cyberimmunity-edu/cyberimmune-systems-autonomous-delivery-drone-with-kos-hardware/README.md

# Киберимунный автономный квадрокоптер

## Подборка материалов для сборки киберимунного квадрокоптера

* [Детали](PARTS_LIST.md)
* [Чертежи и модели](./parts/SCHEMATICS.md)
* [Схемы плат и подключений](./schematics/)
