cyberimmunity-edu/cyberimmune-systems-autonomous-delivery-drone-with-kos-hardware/parts/SCHEMATICS.md

# Чертежи деталей и модели

## Содержание

* [Коптер сборка](#коптер-сборка)
* [Верхняя дека](#верхняя-дека)
* [Комплект стенок](#комплект-стенок)
* [Корпус для 2х компасов V3](#корпус-для-2х-компасов_v3)
* [Корпус под шарик 20мм](#корпус-под-шарик-20мм-v12-2)
* [Крест](#крест)
* [Крышка для 2х компасов V3](#крышка-для-2х-компасов-v3)
* [Нижняя дека](#нижняя-дека)
* [Планшайба килсвитч](#планшайба-килсвитч)
* [Скоба крепления к раме](#скоба-крепления-к-раме)
* [Спуск2](#спуск2)
* [Стойка](#стойка)
* [Фланец Стойки](#фланец-стойки-22)

## Коптер сборка

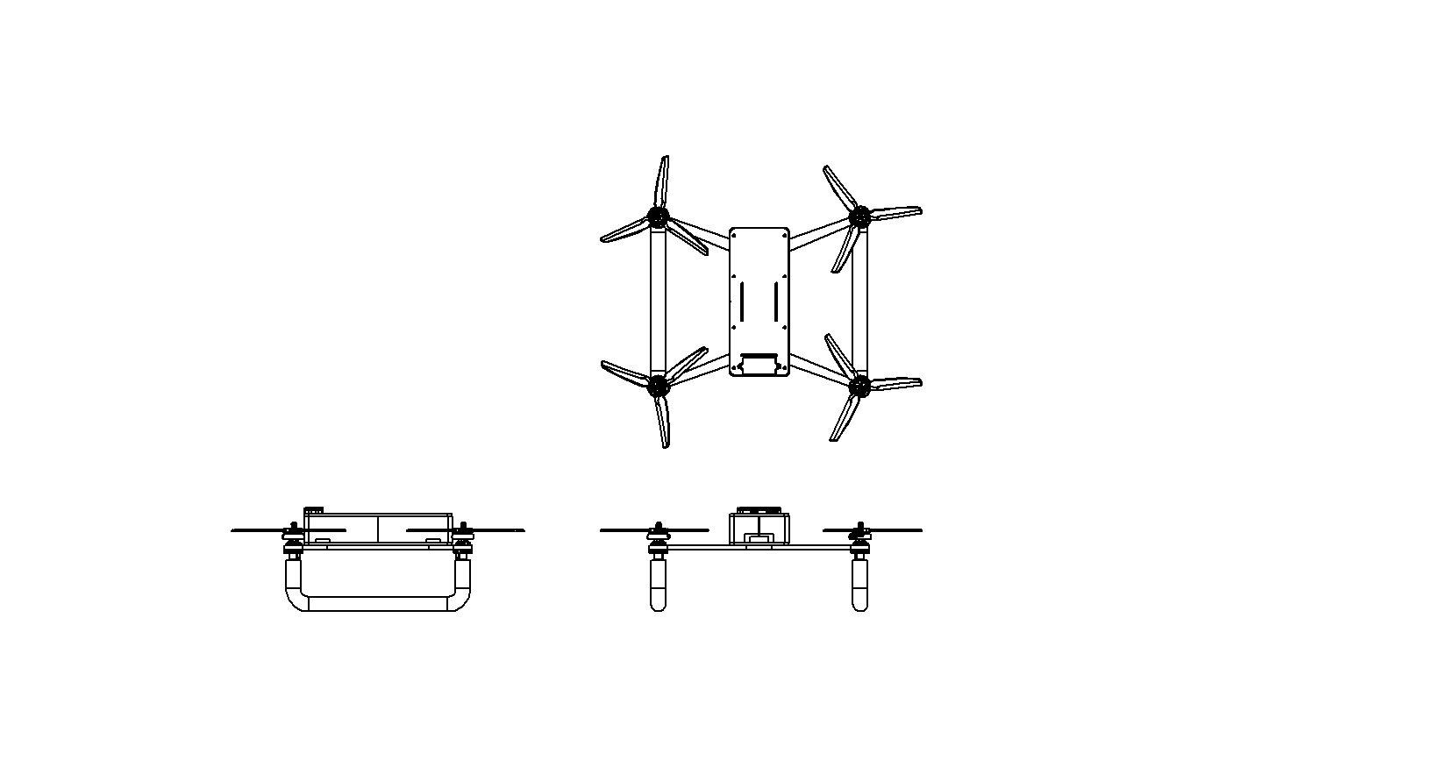
[picture p1: parts/Коптер_сборка.png]

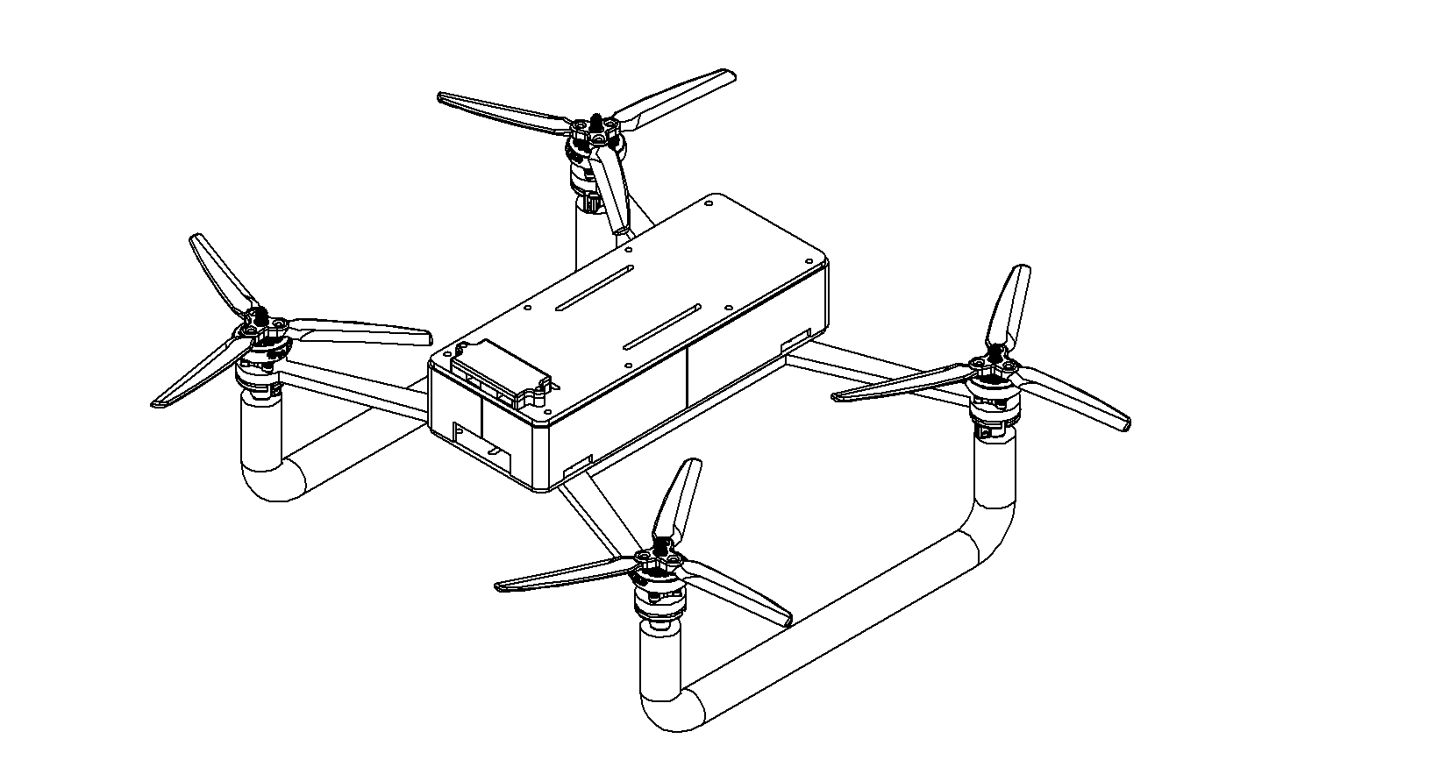
[picture p2: parts/Коптер_сборка_дим.png]


## Верхняя дека

* [Верхняя_дека.DWG](./Верхняя_дека.DWG)
* [Верхняя_дека.SLDPRT](./Верхняя_дека.SLDPRT)

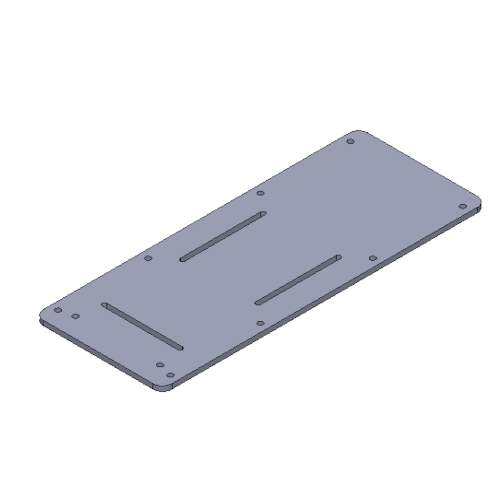
[picture p3: parts/Верхняя_дека.png]

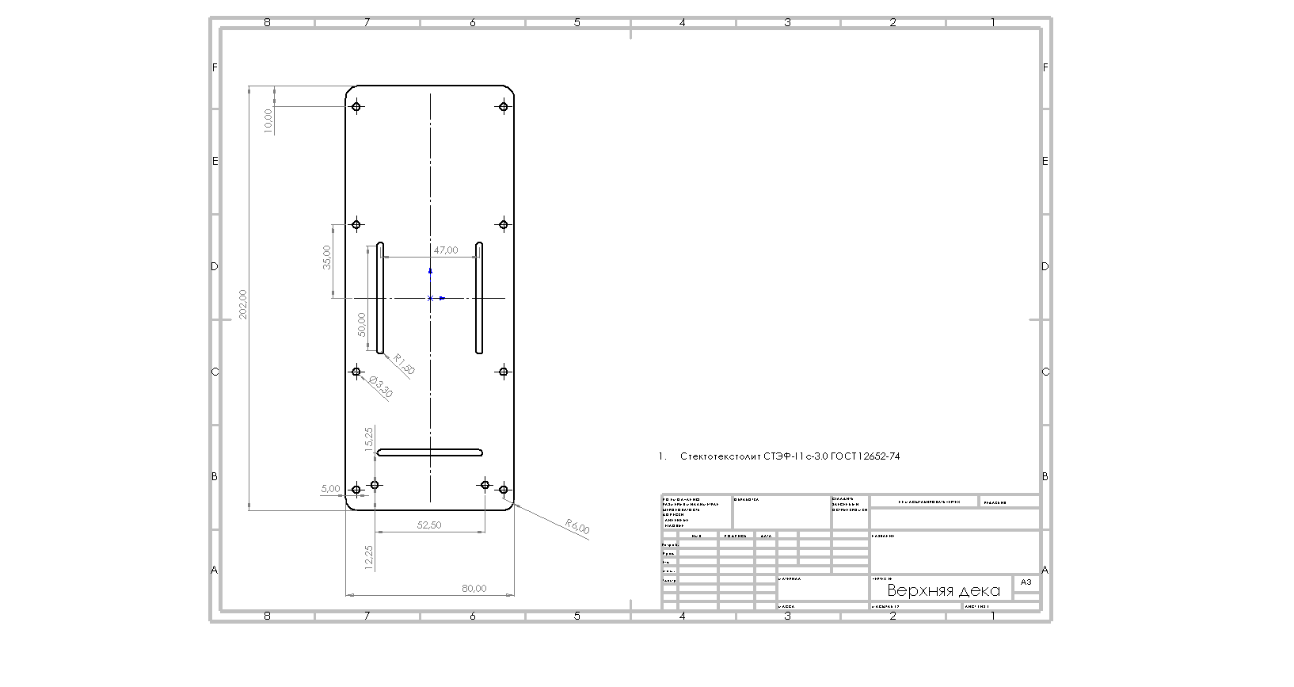
[picture p4: parts/Верхняя_дека_чертёж.png]


## Комплект стенок

* [Комплект_стенок.SLDPRT](./Комплект_стенок.SLDPRT)

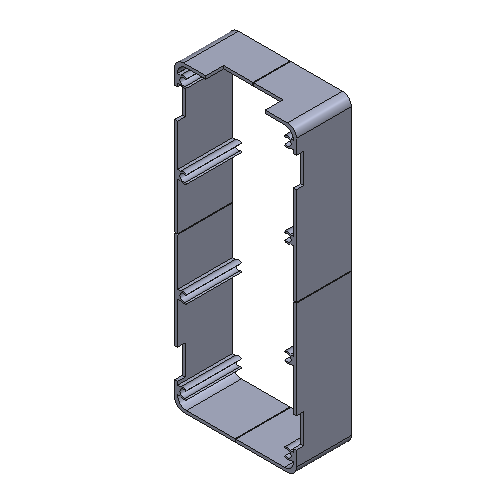
[picture p5: parts/Комплект_стенок.png]

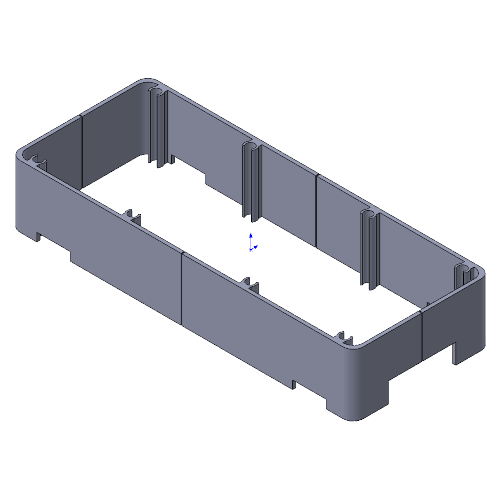
[picture p6: parts/Комплект_стенок2.png]


## Корпус для 2х компасов_V3

* [Корпус_для_2х_компасов_V3.SLDPRT](./Корпус_для_2х_компасов_V3.SLDPRT)

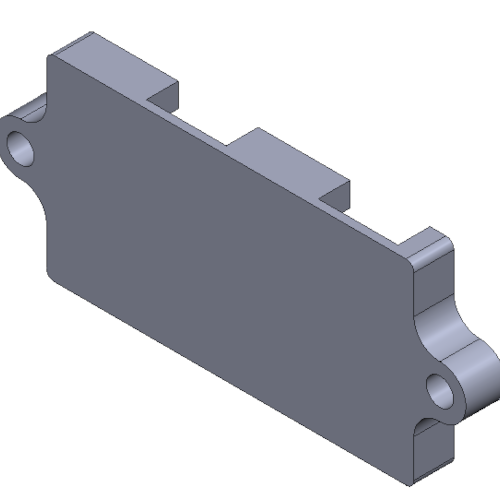
[picture p7: parts/Корпус_для_2х_компасов_V3.png]


## Корпус под шарик 20мм v1.2-2

* [Корпус_под_шарик_20мм_v1.2.SLDPRT](./Корпус_под_шарик_20мм_v1.2.SLDPRT)
* [Корпус_под_шарик_20мм_v1.2.STL](./Корпус_под_шарик_20мм_v1.2.STL)

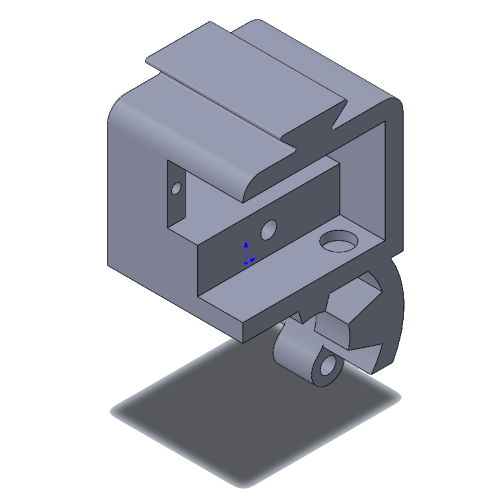
[picture p8: parts/Корпус_под_шарик_20мм_v1.2-2.png]

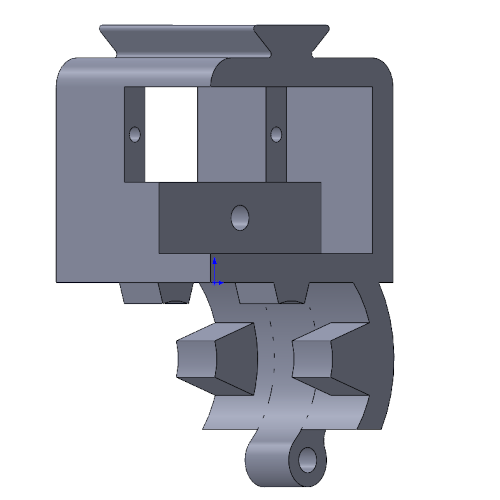
[picture p9: parts/Корпус_под_шарик_20мм_v1.2.png]


## Крест

* [Крест.DWG](./Крест.DWG)
* [Крест.SLDPRT](./Крест.SLDPRT)

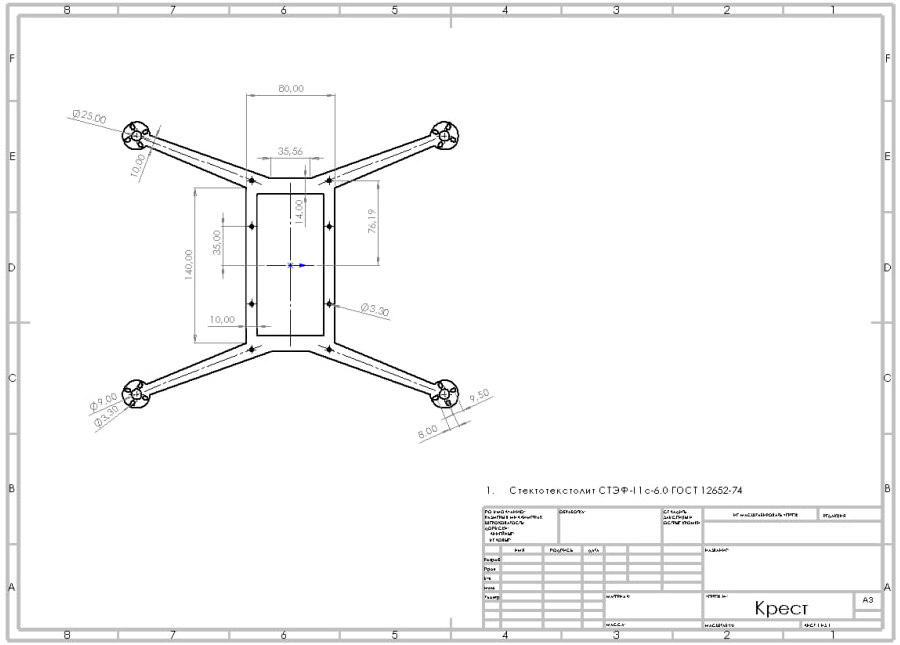
[picture p10: parts/Крест.png]

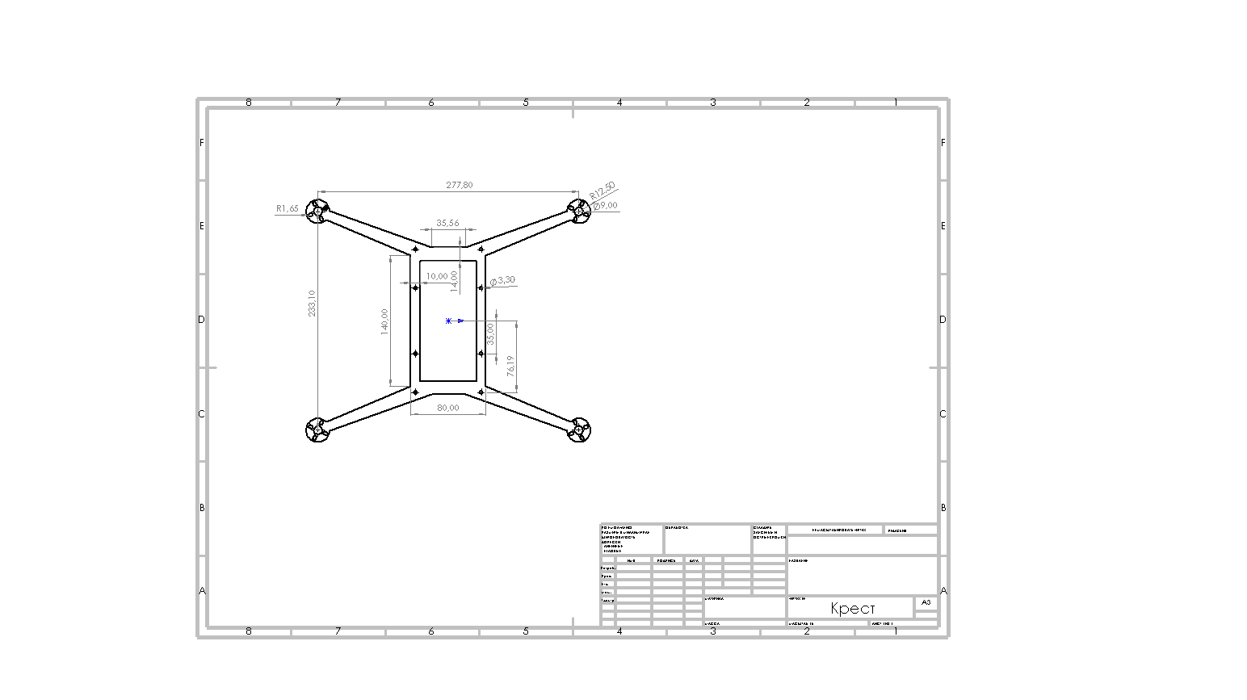
[picture p11: parts/Крест_чертёж.png]


## Крышка для 2х компасов V3

* [Крышка_для_2х_компасов_V3.SLDPRT](./Крышка_для_2х_компасов_V3.SLDPRT)
* [Крышка_под_шарик_20мм_v1.2.SLDPRT](./Крышка_под_шарик_20мм_v1.2.SLDPRT)
* [Крышка_под_шарик_20мм_v1.2.STL](./Крышка_под_шарик_20мм_v1.2.STL)

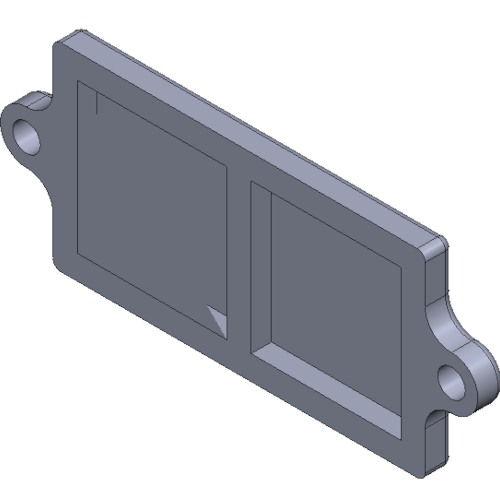
[picture p12: parts/Крышка_для_2х_компасов_V3.png]

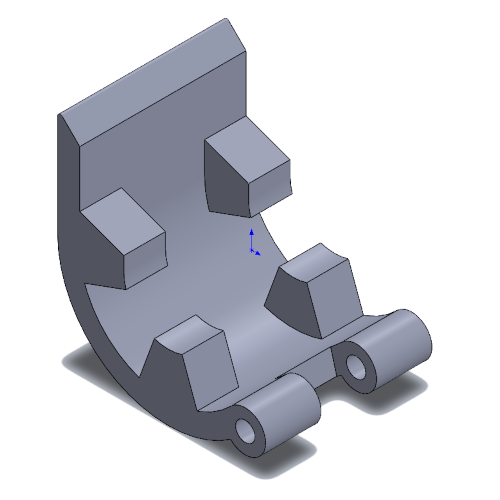
[picture p13: parts/Крышка_под_шарик_20мм_v1.2-2.png]

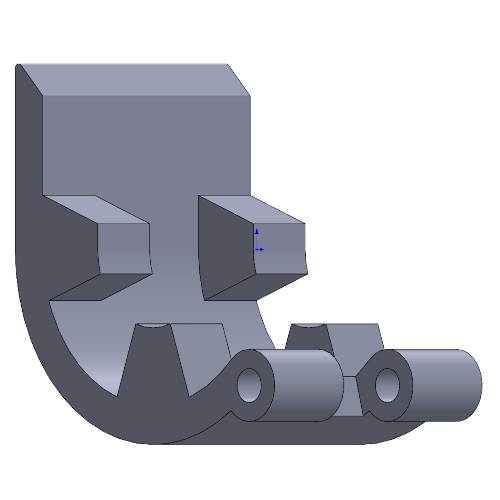
[picture p14: parts/Крышка_под_шарик_20мм_v1.2.png]


## Нижняя дека

* [Нижняя_дека.DWG](./Нижняя_дека.DWG)
* [Нижняя_дека.SLDPRT](./Нижняя_дека.SLDPRT)

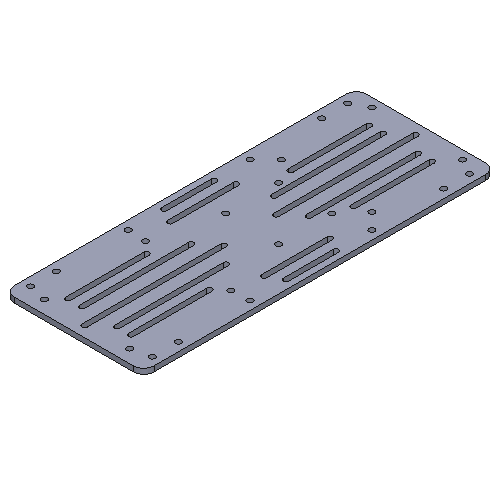
[picture p15: parts/Нижняя_дека.png]

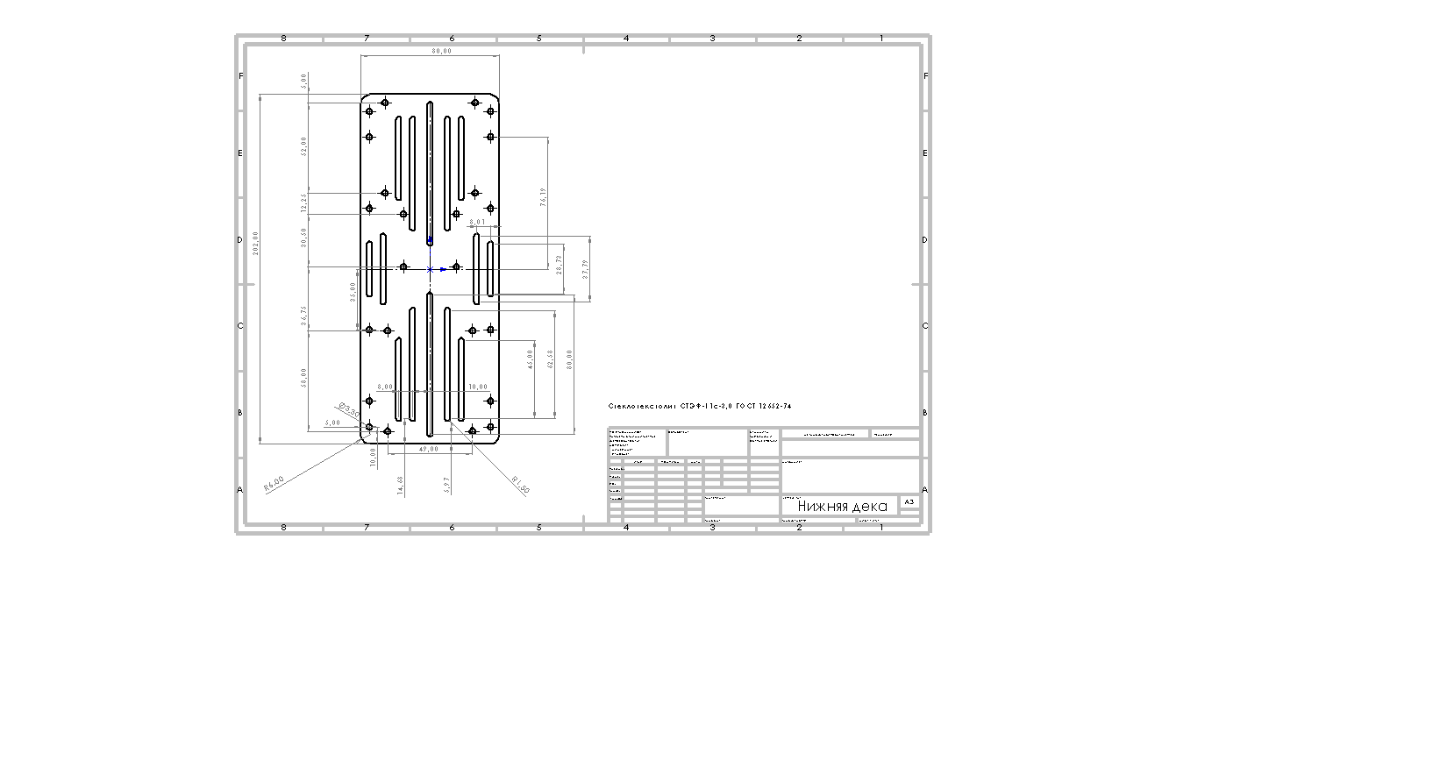
[picture p16: parts/Нижняя_дека_чертёж.png]


## Планшайба килсвитч

* [Планшайба_килсвитч.DWG](./Планшайба_килсвитч.DWG)
* [Планшайба_килсвитч.SLDPRT](./Планшайба_килсвитч.SLDPRT)

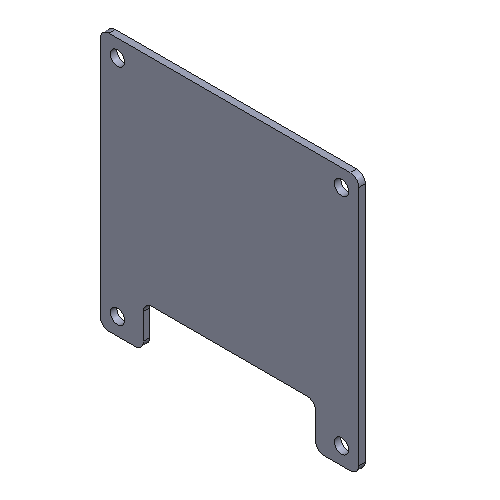
[picture p17: parts/Планшайба_килсвитч.png]

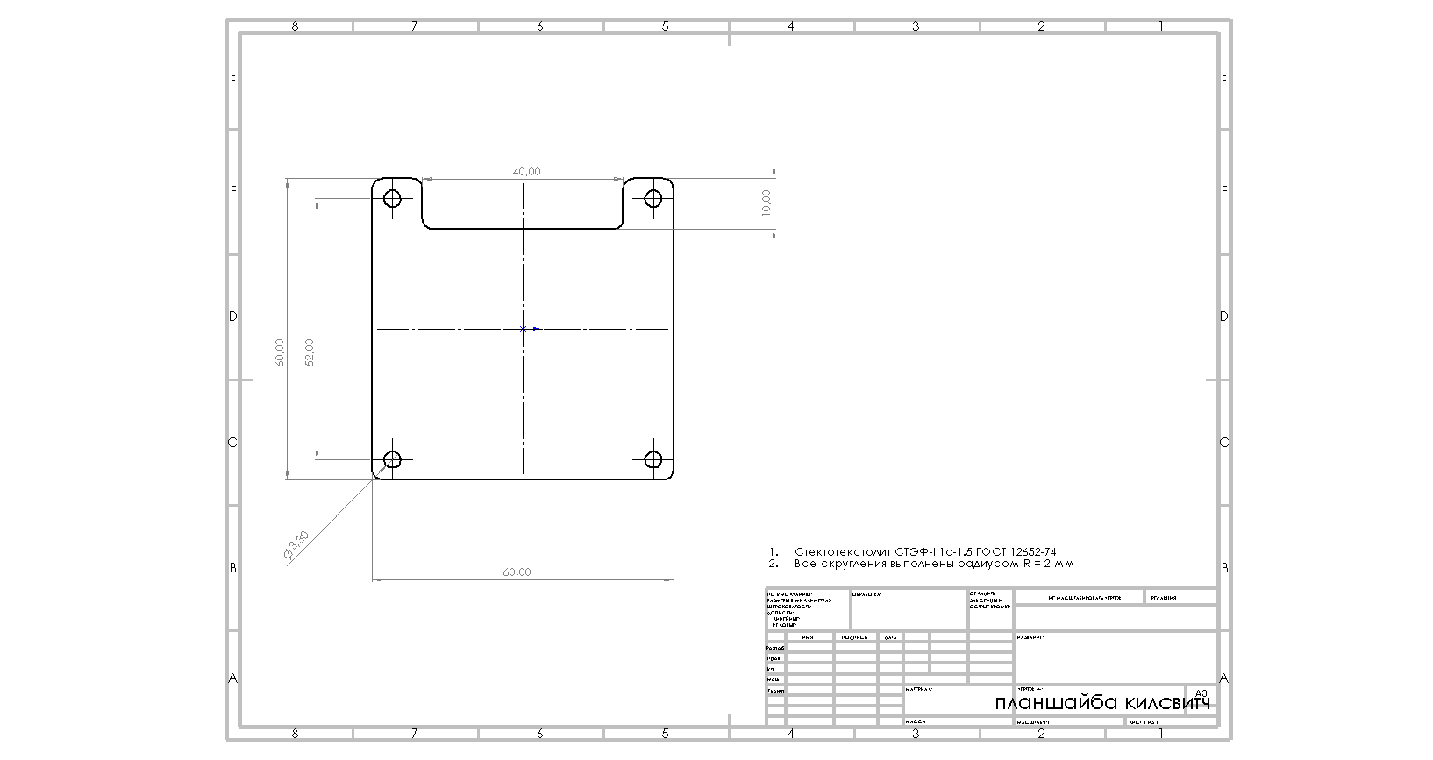
[picture p18: parts/Планшайба_килсвитч_чертёж.png]


## Подвес

* [Подвес_ИТОГ.SLDASM](./Подвес_ИТОГ.SLDASM)

## Рама Сборка

* [Рама_Сборка.SLDASM](./Рама_Сборка.SLDASM)

## Скоба крепления к раме

* [Скоба_крепления_к_раме.SLDPRT](./Скоба_крепления_к_раме.SLDPRT)
* [Скоба_крепления_к_раме.STL](./Скоба_крепления_к_раме.STL)

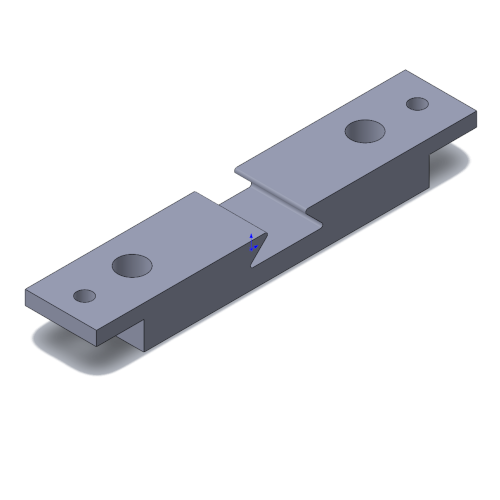
[picture p19: parts/Скоба_крепления_к_раме.png]


## Спуск2

* [Спуск2.SLDPRT](./Спуск2.SLDPRT)
* [Спуск2.STL](./Спуск2.STL)

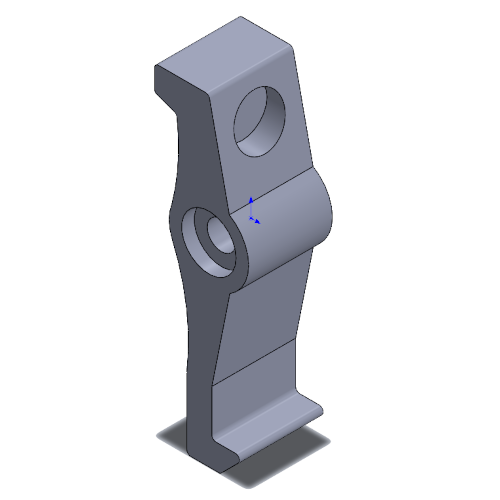
[picture p20: parts/Спуск2.png]


## Стойка

* [Стойка.SLDPRT](./Стойка.SLDPRT)

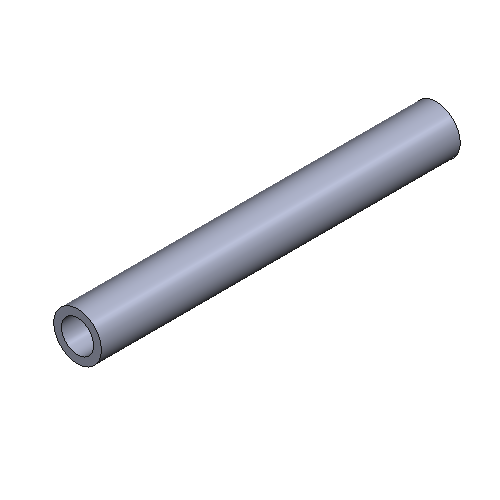
[picture p21: parts/Стойка.png]


## Фланец Стойки 2.2

* [Фланец_Стойки_2.2.SLDPRT](./Фланец_Стойки_2.2.SLDPRT)
* [Фланец_Стойки_2.2.STL](./Фланец_Стойки_2.2.STL)

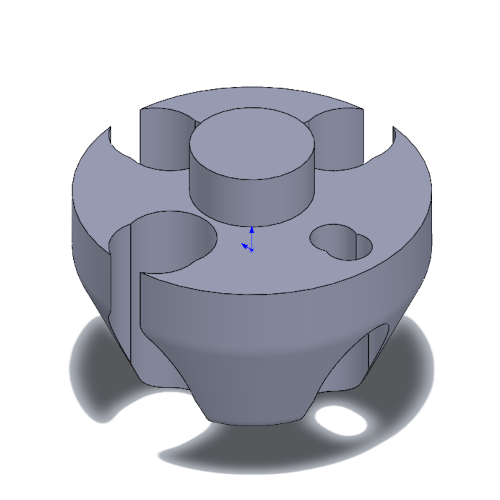
[picture p22: parts/Фланец_Стойки_2.2.png]
