cyberimmunity-edu/cyberimmune-systems-autonomous-delivery-drone-with-kos-hardware/SPECS.md

# **Кибериммунный дрон доставщик**

## **Технические характеристики**

### **Дрон:**

| Взлетная масса | 913 грамм квадр \+ 201 грамм аккум = 1114 грамм общий вес |
| :---: | :---: |
| **Размеры в разложенном состоянии** | В разложенном состоянии (без пропеллеров) 308\*263\*143 (Д × Ш × В) |
| **Размер по диагонали**  | 362,6 мм |
| **Макс. скорость взлета** | в целях безопасности ограничена 3-5 м/с |
| **Макс. скорость снижения** | стандартно 2 м/с, на высоте ниже 1 м замедляется до 1 м/с |
| **Макс. полетная скорость (над уровнем моря, без ветра)** | 2-3 м/с ограничена 5 м/с |
| **Макс. потолок над уровнем моря** | 200 м |
| **Макс. полетное время (без ветра)** | 30 минут |
| **Макс. время зависания (с ветром)** | 23 минуты |
| **Макс. полетное расстояние** | 6 км |
| **Макс. допустимая скорость ветра** |  0-5 м/с комфортный <br /> 5-10 м/сек нагруженный <br /> 10-12 м/с экстремальный |
| **Макс. угол наклона** | 25° |
| **Диапазон рабочих температур** | ОТ \-10° до 40° C |
| **Глобальные системы позиционирования (GNSS)** | GPS \+ Galileo \+ BeiDou+Глонасс |

### **Аккумулятор:**

| Емкость | 4000 мА·ч |
| :---: | :---: |
| **Напряжение** | 14.8 В |
| **Предел напряжения зарядки** | 16.4 В |
| **Тип аккумулятора** | Литий-ионный 4S |
| **Энергетика** | 59.2 Вт·ч |
| **Масса** | 292 г |
| **Диапазон температур зарядки** | \+5°...+40° C |

## **Отличительные особенности:**

* **Автономность.**  
  Отсутствие пульта управления и полеты в режиме полной автономности согласно составленным полетным заданиям.

* **Производительность.**  
  Дрон оснащен высокопроизводительным одноплатным компьютером Raspberry Pi 4b для тестирования алгоритмов обеспечения безопасности полета и не только. Компьютер подключен к полетному контроллеру по интерфейсу UART и осуществляет взаимодействие с KasperskyOS по протоколу, поставляемому в SDK.

* **Безопасность.**  
  Для возможности экстренной остановки двигателей, дрон оборудован системой аварийного выключения используя команды модуля безопасности Raspberry Pi, путем разрыва цепи питания ESC.

* **Связь.**  
  Дрон способен осуществлять передачу телеметрии по протоколу MAVLINK используя сети Wi-Fi по средствам платы расширения ESP32

* **Аккумулятор.**  
  Поддержка любых Li-ion 4S и LiPo 4S аккумуляторов.

* **Полезная нагрузка.**  
  На нижней части квадрокоптера установлено крепление ласточкин хвост для установки и BLS разъем для подключения и подключения полезной нагрузки. Также предусмотрен модуль реле для принудительной деактивации полезной нагрузки.
