cyberimmunity-edu/cyberimmune-systems-autonomous-delivery-drone-with-kos-hardware/schematics/Gerber_PCB_Buzzer_2024-06-27.png

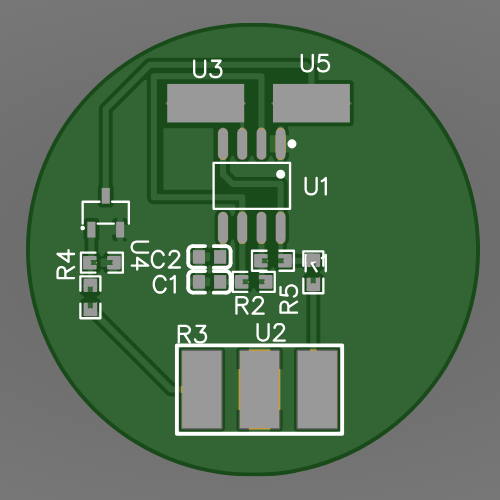
schematics/Gerber_PCB_Buzzer_2024-06-27.png
