cyberimmunity-edu/cyberimmune-systems-autonomous-delivery-drone-with-kos-hardware/schematics/scheme.jpg

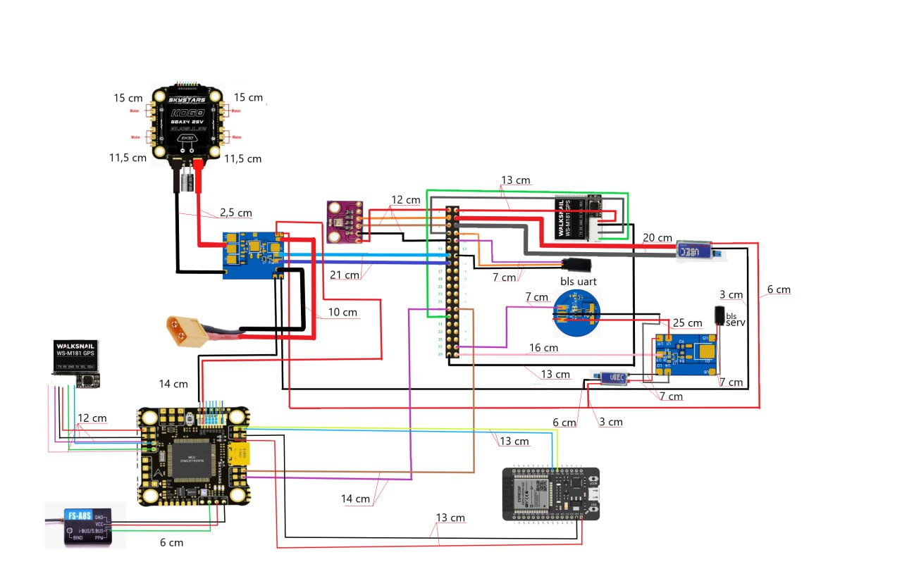
schematics/scheme.jpg
