cyberimmunity-edu/cyberimmune-systems-autonomous-delivery-drone-with-kos-hardware/schematics/scheme.png

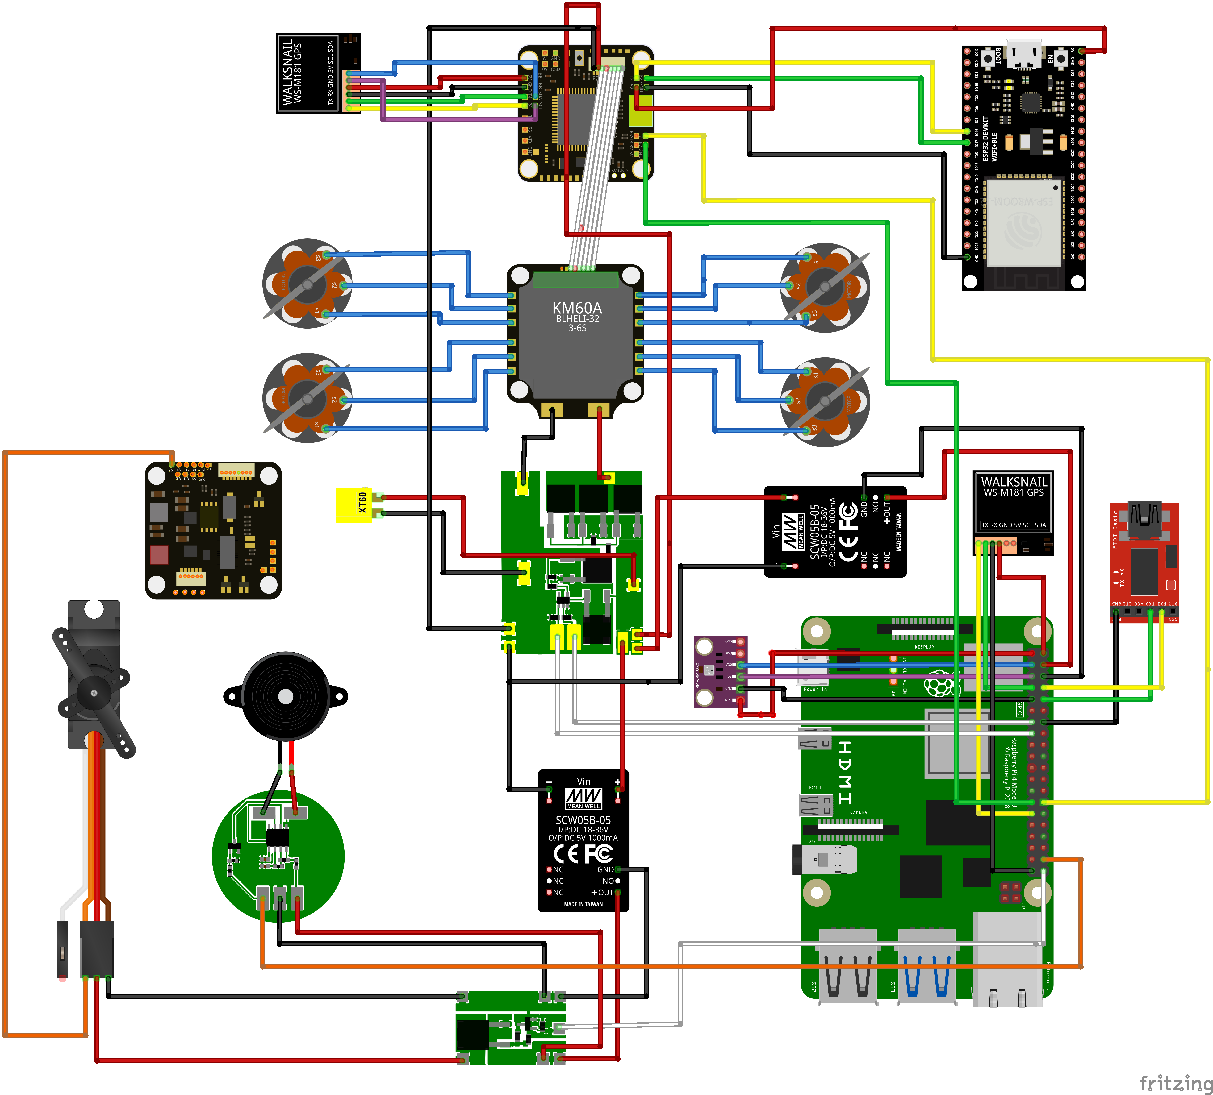
schematics/scheme.png
