cyberimmunity-edu/cyberimmune-systems-autonomous-delivery-drone-with-kos-hardware/PARTS_LIST.md

# Список запчастей

| Наименование | Количество | Примечание  |
| --- | --- | --- |
| 2N7002MTF исполнение SOT-23-3 | 1 | шт buzzer |
| 2N7002MTF исполнение SOT-23-3 | 1 | шт - реле |
| Аккумулятор 14.8В 3000мАч 4S LiIon XT60 GEPRC VTC6 18650 | 1 |  |
| Алюминевый скотч | 405 | В мм, на один коптер Экранирование gps на верхней деке,  возможно будем убирать. |
| антенна rasberry 2.4 | 1 шт или 2 | |
| Барометр BMP280 | 1 | Барометр |
| Болт М2.5 полиамид | 4 | Крепление raspberry |
| Болт М3 полиамид | 4 | Крепление планшайбы, предложение заменить на 2,5 с целью унификации |
| Зарядное устройство | 1 | Для зарядки аккумуляторов. |
| Изолента черная | 2 рулона | Крепление проводов к лучам |
| Кабель канал спиральный 8 мм | 1 рулон | Кабель менеджмент |
| карты памяти 8GB 10класс  | 1 | Запись системы KOS |
| Ключ для BLS разъема | 1 | Пластмаска со штырьком что бы не перепутать подключение |
| Ключ М8 | 1 | Для моторов |
| Колодка 40 Pin | 1 | Подключение на гребенку RPi |
| Комплект стенок | 1 | ABS пластик (18891мм), на 1 комплект в комплекте (4 детали) |
| кондер  10 nF исполнение С0603 | 1 | шт buzzer |
| кондер 33 nF исполнение С0603 | 1 | шт buzzer |
| Коробка 335*290*175мм | 1 |  |
| Корпус | 1 | ABS пластик (8624мм),  на 1шт. |
| Корпус для 2-х компасов | 1 | ABS пластик (1533мм) на 1шт. |
| Крышка | 1 | ABS пластик (4782мм), на 1шт. |
| Крышка для 2-х компасов | 1 | ABS пластик (1076мм) на 1 шт. |
| Маска  Dynamask 5030 | 1 рулон | Защита и изоляция самодельных плат |
| Модуль реле | 1 | Собственное производство  |
| Пластина крепления | 1 | ABS пластик (3095мм),  на 1шт. |
| Припой | 1 катушка | Пайка |
| Пропеллеры HQProp J75 CCW | 2 |  |
| Пропеллеры HQProp J75 CW | 2 |  |
| Пружина 0,5*4,3*12 n=6 | 1 | Подходит от авторучки |
| резистор 10 кОМ исполнение R0603 | 2 | шт buzzer |
| резистор 10 кОМ исполнение R0603 | 3 | шт - killswitch |
| резистор 10 кОМ исполнение R0603 | 1 | шт - реле |
| резистор 100 кОм исполнение R0603 | 1 | шт - killswitch |
| резистор 100 кОм исполнение R0603 | 1 | шт - реле |
| резистор 100 Ом исполнение R0603 | 2 | шт buzzer |
| резистор 100 Ом исполнение R0603 | 2 | шт - killswitch |
| резистор 100 Ом исполнение R0603 | 2 | шт - реле |
| резистор 11 кОм исполнение R0603 | 1 | шт buzzer |
| Сервопривод MG-90 | 1 | Комплект с винтами и качалками |
| Силиконовый провод 14awg красный | 50 | мм, +, KS -> ESC |
| Силиконовый провод 14awg чёрный  | 50 | мм, gnd, KS -> ESC |
| Силиконовый провод awg28 белый | 100 | мм, control, RPi => Buzzer |
| Силиконовый провод awg28 белый | 210 | мм, control, KS=>RPi |
| Силиконовый провод awg28 белый | 210 | мм, control, KS=>RPi |
| Силиконовый провод awg28 желтый | 120 | мм, Tx, Bar -> RPi |
| Силиконовый провод awg28 желтый | 130 | мм, Tx, ESP32 => RPi |
| Силиконовый провод awg28 желтый | 140 | мм, Tx, ПК => RPi |
| Силиконовый провод awg28 желтый | 70 | мм, Tx, RPi => UART |
| Силиконовый провод awg28 желтый | 300 | мм, Tx, TTL => UART |
| Силиконовый провод awg28 зелёный | 120 | мм,  Rx, Bar -> RPi |
| Силиконовый провод awg28 зелёный | 130 | мм, Rx, ESP32 => RPi |
| Силиконовый провод awg28 зелёный | 140 | мм, Rx, ПК => RPi |
| Силиконовый провод awg28 зелёный | 70 | мм, Rx, RPi => UART |
| Силиконовый провод awg28 зелёный | 300 | мм, Rx, TTL => UART |
| Силиконовый провод awg28 красный | 120 | мм, VCC, Bar -> RPi |
| Силиконовый провод awg28 красный | 130 | мм, gnd, ESP32 => RPi |
| Силиконовый провод awg28 красный | 180 | мм, +,  МР => Buzzer |
| Силиконовый провод awg28 красный | 70 | мм, наращивание питания на ПК |
| Силиконовый провод awg28 чёрный | 120 | мм, gnd |  Bar -> RPi |
| Силиконовый провод awg28 чёрный | 130 | мм, + |  ESP32 => RPi |
| Силиконовый провод awg28 чёрный | 70 | мм, gnd |  RPi => UART |
| Силиконовый провод awg28 чёрный | 180 | мм, gnd |  МР => Buzzer |
| Силиконовый провод awg28 чёрный | 70 | мм, наращивание питания на ПК |
| Силиконовый провод awg28 чёрный | 300 | мм, gnd |  TTL => UART |
| Скотч двухсторонний | 1 рулон | Креплние UART, бары KillSwitch, esp32, модуль реле, пропеллеры для транспортировки |
| Сода кальцинированная | 1 упаковка | Чистка самодельных плат от маски |
| Спуск | 1 | ABS пластик(851мм), на 1шт. |
| Стеклотекстолит типа FR4 | 1 | 30x30mm buzzer |
| Стеклотекстолит типа FR4 | 1 | 42х32mm - killswitch |
| Стеклотекстолит типа FR4 | 1 | 25х18мм- реле |
| Стойка алюминиевая М3*37мм | 8 | Использованы стойки геоскана, есть предложение замены на 35мм(место позволяет, плюс экономия веса) или на 40мм (Есть в магазинах), либо заказ из Китая 37мм |
| Стойка нейлоновая для печатных плат HTS M2,5*6 | 4 | Крепление raspberry |
| Стойка нейлоновая для печатных плат HTS M3*20 | 4 | Крепление планшайбы, предложение заменить на 2,5 с целью унификации |
| Столбики из ППЭ 50*20*175 | 4 |  |
| Стэк Skystars H7HD + KM60 | 1 | ПК + ESC |
| Текстолит СТЭФ-I, 1.5 мм | 1 | полка заготовка (60*60*1,5), возможно количество будет изменено на 2шт. |
| Текстолит СТЭФ-I, 3 мм | 2 | верхняя дека и нижняя дека (202*80*3)*2, возможно замена материала на 1,5мм на верхней деке, а возможно и на обоих |
| Текстолит СТЭФ-I, 6 мм | 1 | крест рамы, (258,1*302,8*6) |
| Теплоизоляция для труб 22*6 мм | 343 | Вспененный полиэтилен |
| Трубка алюминиевая 6*1 мм | 363мм | Нужен трубогиб |
| Трубка термоусадочная d1/0,5 белая | 1 рулон (5м) | Изоляция паяльных соединений |
| Фланец стойки шасси (3д печать) | 4 | ABS пластик (2119мм) на 1шт. |
| Флюс паяльный |  1 тюбик | Пайка |
| Шлейка для крепления Акб | 1 |  |
| BL-T, контакт для BLS и BLD | 22 | Колодка 40 Pin мамы |
| BL-TM, контакт для BLS и BLD | 3 | Вывод UART, BLS 3pin папы(штырьки) |
| BLS 3pin | 1 | Подключение Uart |
| BLS 3pin с ключом | 1 | Подключение Uart |
| Buzzer | 1 | Собственное производство  |
| Buzzer(ardupilot) | 1 | шт buzzer |
| DIN 555 / DIN 934 Гайка шестигранная с фаской M2.5 Полиамид | 4 | Крепление raspberry |
| DIN 555 / DIN 934 Гайка шестигранная с фаской M2.5 Полиамид | 4 | Крепление планшайбы, предложение заменить на 2,5 с целью унификации |
| DIN 912 / ISO 4762 Винт с цилиндрической головкой и внутренним шестигранником M3*12 | 2 | Крепление креста с нижней декой к стойкам |
| DIN 912 / ISO 4762 Винт с цилиндрической головкой и внутренним шестигранником M3*16 | 4 | Крепление нижней деки к кресту |
| DIN 912 / ISO 4762 Винт с цилиндрической головкой и внутренним шестигранником M3*6 | 12 | Крепление верхней деки к стойкам (8шт.), крепление нижней деки к стойкам (4шт.) |
| DIN 912 Винт с внутренним шестигранником М3*10 | 12 |  |
| DIN 912 Винт с внутренним шестигранником М3*16 | 2 | Крепление к раме в стойку ISO 4762, ГОСТ 11738-84 |
| DIN 912 Винт с внутренним шестигранником М3*16 | 2 | ISO 4762, ГОСТ 11738-84 |
| DIN 912 Винт с внутренним шестигранником М3*16 | 4 | ISO 4762, ГОСТ 11738-84 |
| DIN 912 Винт с внутренним шестигранником М3*35 | 2 | ISO 4762, ГОСТ 11738-84 |
| DIN 985 / ISO 10511 Гайка шестигранная самоконтрящаяся с нейлоновой вставкой M3 Цинк  | 4 | Крепление нижней деки к кресту |
| DIN 985 Гайка шестигранная самоконтрящаяся с нейлоновой вставкой M3 | 2 | ISO 10511 |
| DIN 985 Гайка шестигранная самоконтрящаяся с нейлоновой вставкой M3 | 2 | ISO 10511 |
| ESP 32 DevKit1(wroom32) | 1 | Соединение по Wi-fi |
| FDD6637 исполнение TO-252-3 | 3 | шт - killswitch |
| FDD6637 исполнение TO-252-3 | 1 | шт - реле |
| KillSwitch | 1 | Собственное производство  |
| L7805CDT-TR исполнение TO-252-3 | 1 | шт - killswitch |
| NE555DR исполнение SOIC-8 | 1 | шт buzzer |
| P0903BDG-VB исполнение TO-252 | 1 | шт - killswitch |
| RaspberryPi 4B | 1 | МК Размещение клиента ОРВД |
| SN74AHC1G86DBVR исполнение SOT-23-5 | 1 | шт - killswitch |
| TTL convertor | 1 | Подключение к компьютеру |
| UBec 5V 3A  | 2 | Стабилизатор напряжения, есть мнение оставить 1шт. |
| Walksnail WS-M181 GPS с компасом | 2 | Gps компас |
