cyberimmunity-edu/cyberimmune-systems-autonomous-delivery-drone-with-kos-hardware/parts/Подвес_ИТОГ.SLDASM

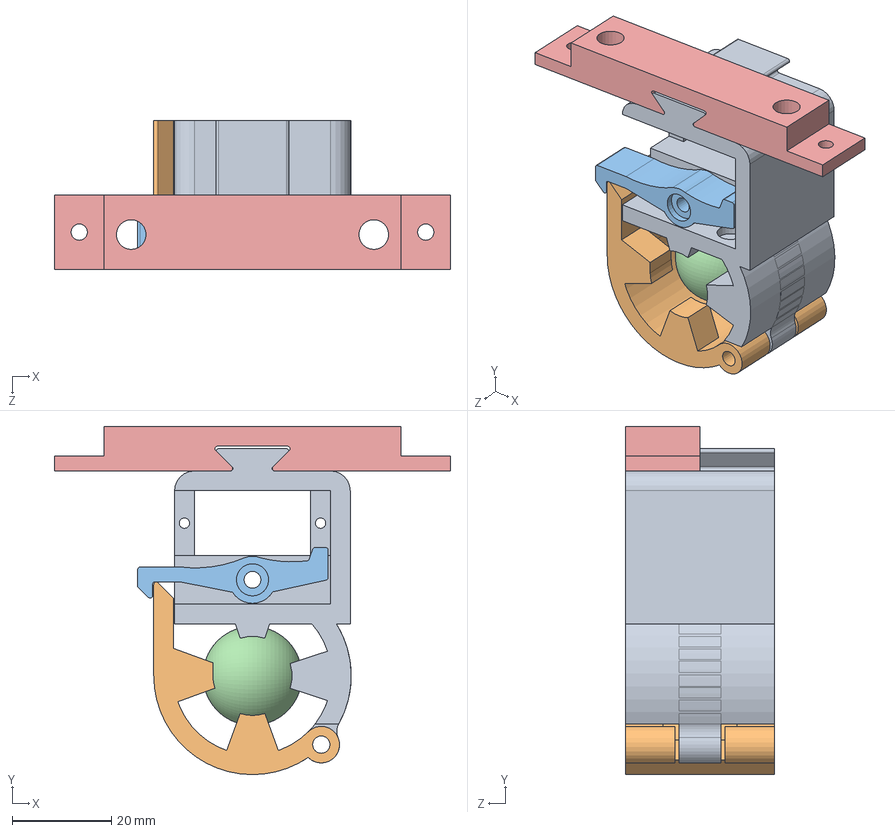
[picture p28: CAD file, 2024-08-05]
parts/Подвес_ИТОГ.SLDASM
80.0 x 70.3 x 30.0 mm
Корпус под шарик 20мм v1.2
Крышка под шарик 20мм v1.2
спуск2
шар 21мм
Скоба крепления к раме
