cyberimmunity-edu/cyberimmune-systems-autonomous-delivery-drone-with-kos-hardware/parts/Рама_Сборка.SLDASM

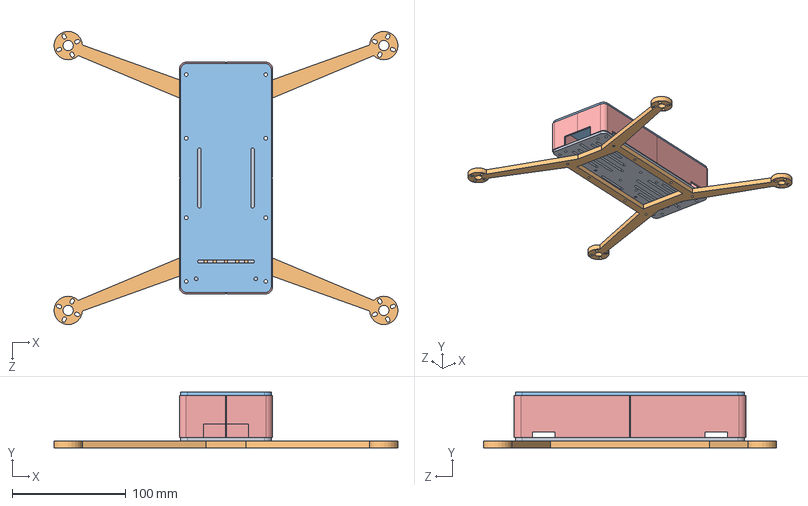
[picture p29: CAD file, 2024-07-04]
parts/Рама_Сборка.SLDASM
302.8 x 49.0 x 258.1 mm
Нижняя дека
Крест
Верхняя дека
Стойка x 8
Комплект стенок
