cyberimmunity-edu/cyberimmune-systems-autonomous-delivery-drone-with-kos-hardware/parts/Фланец_Стойки_2.2.SLDPRT

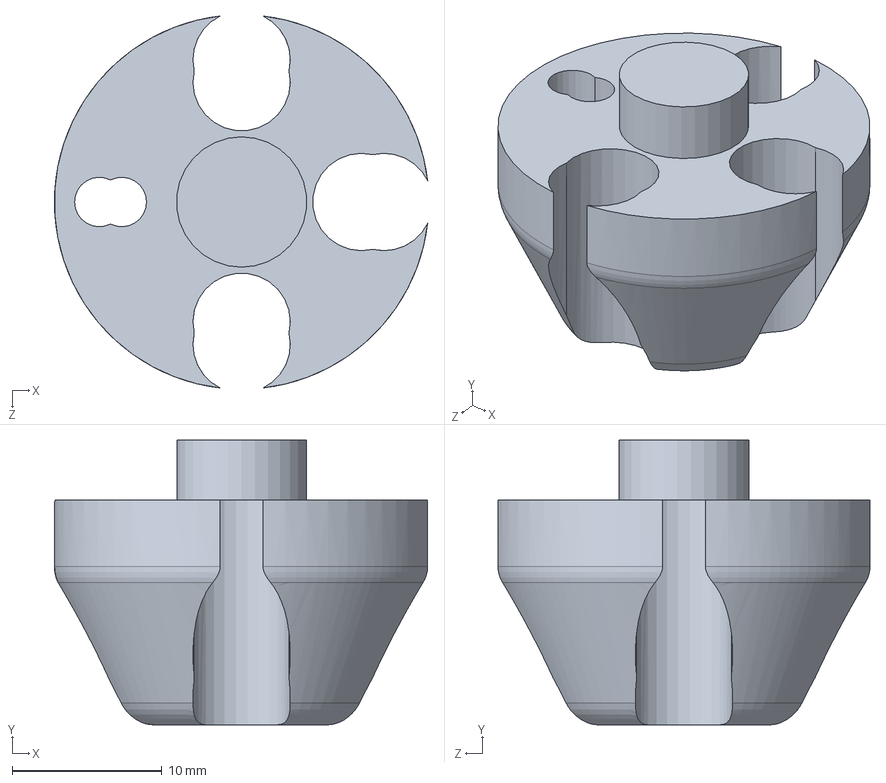
[picture p30: CAD file, 2024-08-05]
parts/Фланец_Стойки_2.2.SLDPRT
24.9 x 19.0 x 24.8 mm
