cyberimmunity-edu/cyberimmune-systems-autonomous-delivery-drone-with-kos-hardware/parts/Корпус_под_шарик_20мм_v1.2.SLDPRT

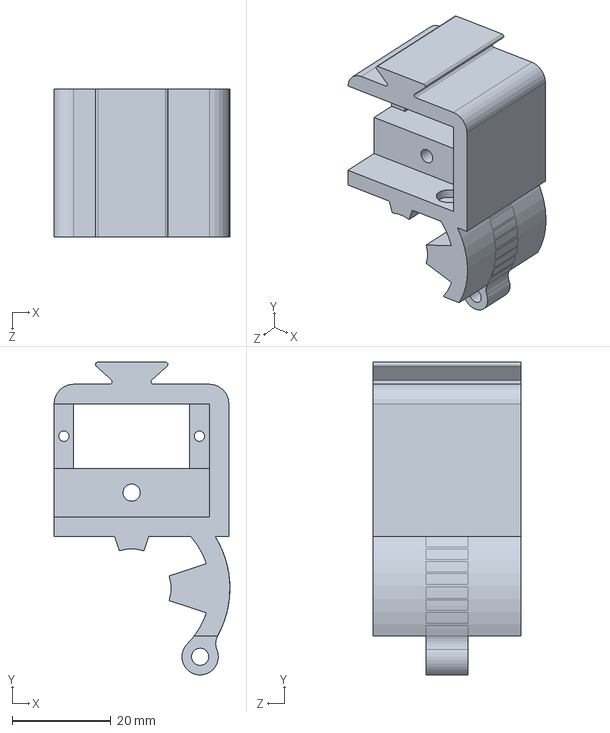
[picture p31: CAD file, 2024-08-05]
parts/Корпус_под_шарик_20мм_v1.2.SLDPRT
35.7 x 63.5 x 30.0 mm
