cyberimmunity-edu/cyberimmune-systems-autonomous-delivery-drone-with-kos-hardware/parts/Спуск2.SLDPRT

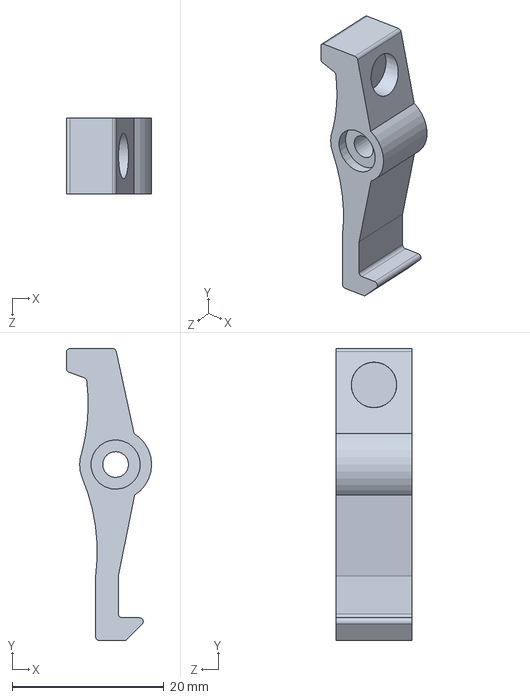
[picture p32: CAD file, 2024-08-05]
parts/Спуск2.SLDPRT
11.2 x 38.5 x 10.0 mm
