cyberimmunity-edu/cyberimmune-systems-autonomous-delivery-drone-with-kos-hardware/parts/Скоба_крепления_к_раме.SLDPRT

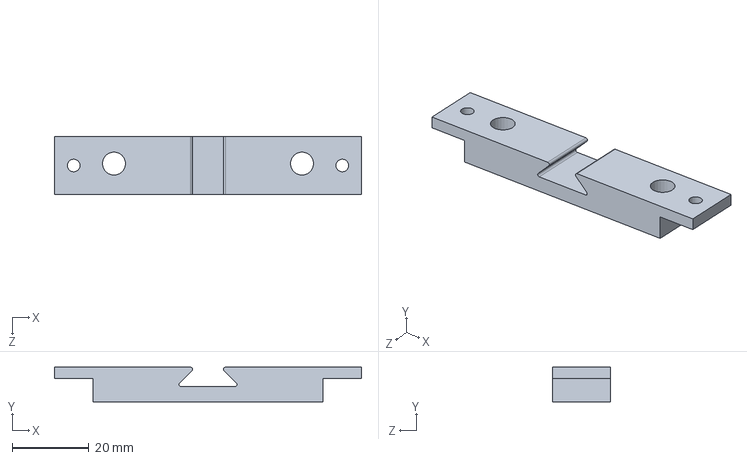
[picture p33: CAD file, 2024-08-05]
parts/Скоба_крепления_к_раме.SLDPRT
80.0 x 9.00 x 15.0 mm
