cyberimmunity-edu/cyberimmune-systems-autonomous-delivery-drone-with-kos-hardware/parts/Крышка_под_шарик_20мм_v1.2.SLDPRT

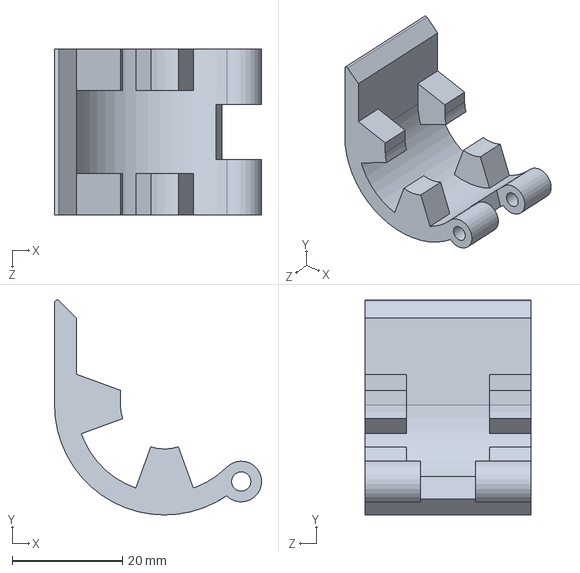
[picture p34: CAD file, 2024-08-05]
parts/Крышка_под_шарик_20мм_v1.2.SLDPRT
37.5 x 38.9 x 30.0 mm
