cyberimmunity-edu/cyberimmune-systems-autonomous-delivery-drone-with-kos-hardware/parts/Верхняя_дека.SLDPRT

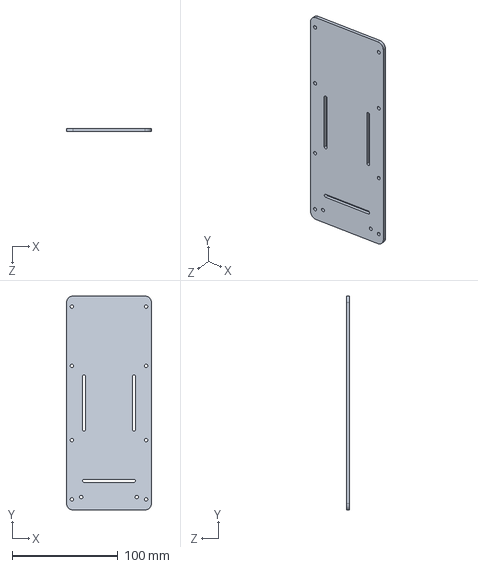
[picture p35: CAD file, 2024-07-04]
parts/Верхняя_дека.SLDPRT
80.0 x 202.0 x 3.00 mm
