cyberimmunity-edu/cyberimmune-systems-autonomous-delivery-drone-with-kos-hardware/parts/Планшайба_килсвитч.SLDPRT

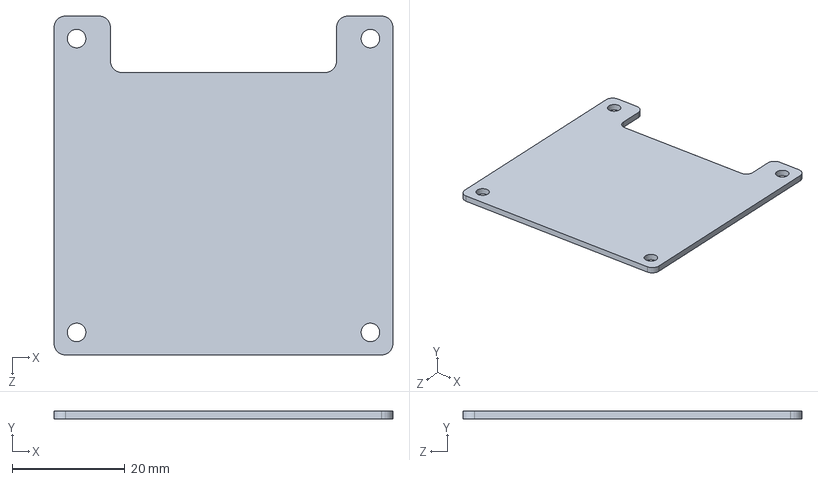
[picture p36: CAD file, 2024-07-04]
parts/Планшайба_килсвитч.SLDPRT
60.0 x 1.50 x 60.0 mm
