cyberimmunity-edu/cyberimmune-systems-autonomous-delivery-drone-with-kos-hardware/parts/Стойка.SLDPRT

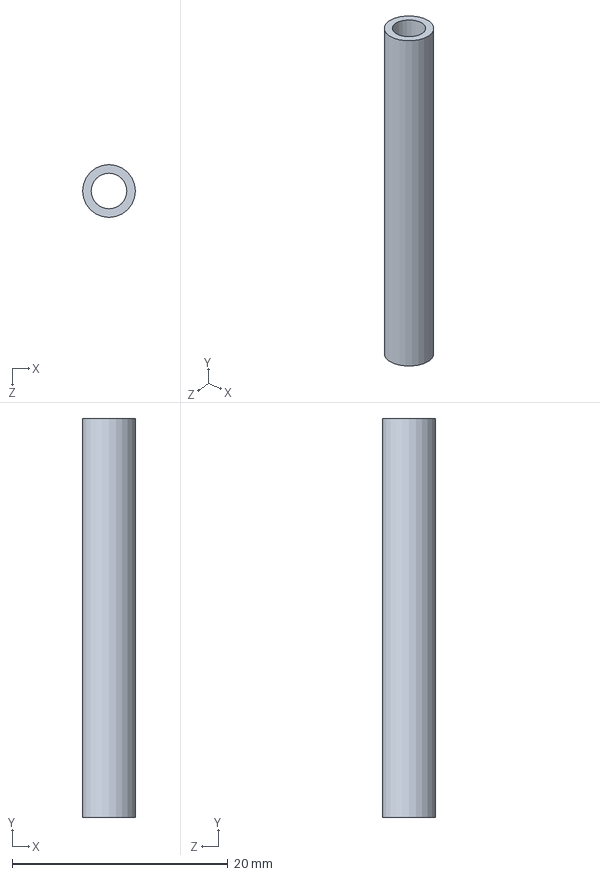
[picture p37: CAD file, 2024-07-04]
parts/Стойка.SLDPRT
4.90 x 37.0 x 4.90 mm
