cyberimmunity-edu/cyberimmune-systems-autonomous-delivery-drone-with-kos-hardware/parts/Крышка_для_2х_компасов_V3.SLDPRT

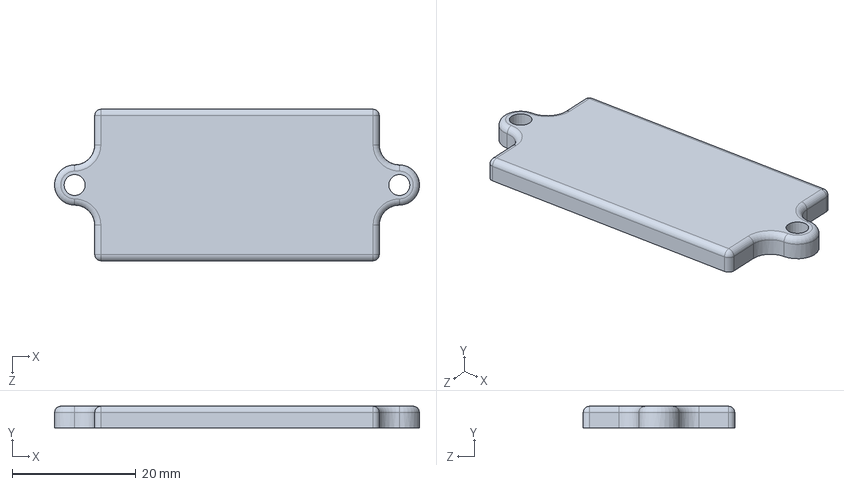
[picture p38: CAD file, 2024-07-04]
parts/Крышка_для_2х_компасов_V3.SLDPRT
59.0 x 3.50 x 24.5 mm
