cyberimmunity-edu/cyberimmune-systems-autonomous-delivery-drone-with-kos-hardware/parts/Корпус_для_2х_компасов_V3.SLDPRT

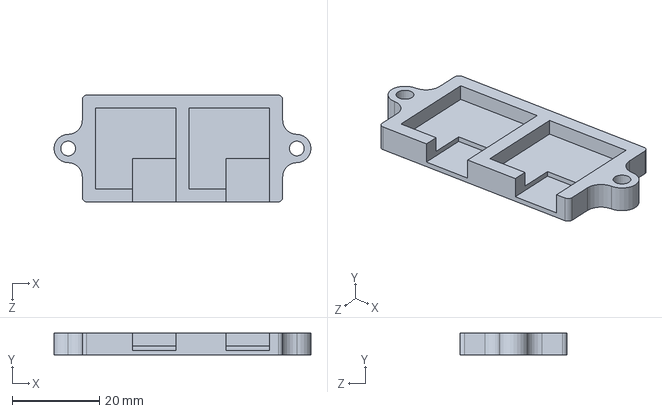
[picture p39: CAD file, 2024-07-04]
parts/Корпус_для_2х_компасов_V3.SLDPRT
59.0 x 5.00 x 24.5 mm
