cyberimmunity-edu/cyberimmune-systems-autonomous-delivery-drone-with-kos-hardware/parts/Крест.SLDPRT

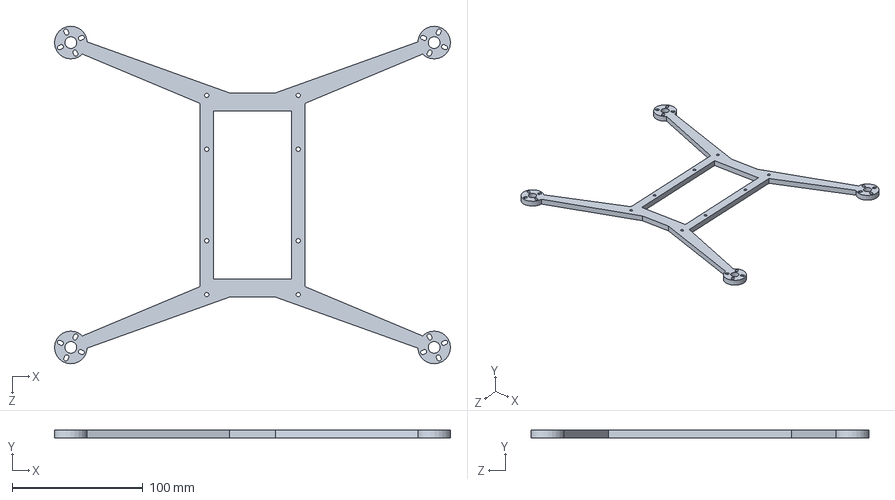
[picture p40: CAD file, 2024-07-04]
parts/Крест.SLDPRT
302.8 x 6.00 x 258.1 mm
