cyberimmunity-edu/cyberimmune-systems-autonomous-delivery-drone-with-kos-hardware/parts/Комплект_стенок.SLDPRT

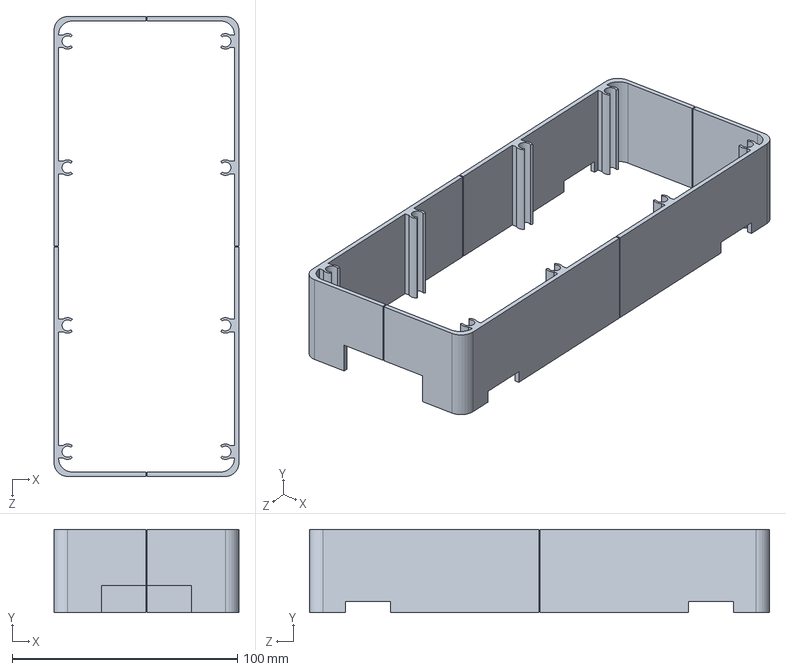
[picture p41: CAD file, 2024-07-04]
parts/Комплект_стенок.SLDPRT
82.0 x 37.0 x 204.0 mm
