cyberimmunity-edu/cyberimmune-systems-autonomous-delivery-drone-with-kos-hardware/(list of files, cad)

Other CAD files:
parts/Нижняя_дека.SLDPRT
parts/Верхняя_дека.DWG
parts/Корпус_под_шарик_20мм_v1.2.STL
parts/Крест.DWG
parts/Крышка_под_шарик_20мм_v1.2.STL
parts/Нижняя_дека.DWG
parts/Планшайба_килсвитч.DWG
parts/Скоба_крепления_к_раме.STL
parts/Спуск2.STL
parts/Фланец_Стойки_2.2.STL
