cyberimmunity-edu/cyberimmune-systems-autonomous-delivery-drone-with-kos-hardware/(list of files, drawings)

Other design files:
schematics/scheme.fzz
