cyberimmunity-edu/cyberimmune-systems-autonomous-delivery-drone-with-kos-hardware/(commit log)

2024-07-04 feat: initial commit
    [Верхняя_дека.SLDPRT, Комплект_стенок.SLDPRT, Корпус_для_2х_компасов_V3.SLDPRT, Крест.SLDPRT, Крышка_для_2х_компасов_V3.SLDPRT, Нижняя_дека.SLDPRT, Планшайба_килсвитч.SLDPRT, Рама_Сборка.SLDASM]
2024-07-13 docs: hw assemble
2024-08-05 docs: more parts have been added
    [Корпус_под_шарик_20мм_v1.2.SLDPRT, Корпус_под_шарик_20мм_v1.2.STL, Крышка_под_шарик_20мм_v1.2.SLDPRT, Крышка_под_шарик_20мм_v1.2.STL, Подвес_ИТОГ.SLDASM, Скоба_крепления_к_раме.SLDPRT, Скоба_крепления_к_раме.STL, спуск2.SLDPRT]
2024-08-05 docs: one more part
    [Фланец_Стойки_2.2.SLDPRT, Фланец_Стойки_2.2.STL]
2024-08-08 docs: more parts
    [Верхняя_дека.DWG, Крест.DWG, Нижняя_дека.DWG, Планшайба_килсвитч.DWG]
2024-08-08 docs: schematics document
    [Спуск2.SLDPRT, Спуск2.STL]
2024-08-09 docs: one part has been changed
    [Крест.DWG]
2024-09-05 docs: scheme.png
    New view scheme
    [scheme.fzz]
